bashar-ghosheh/WRO-Competition/ESP32-V3-pinout.webp

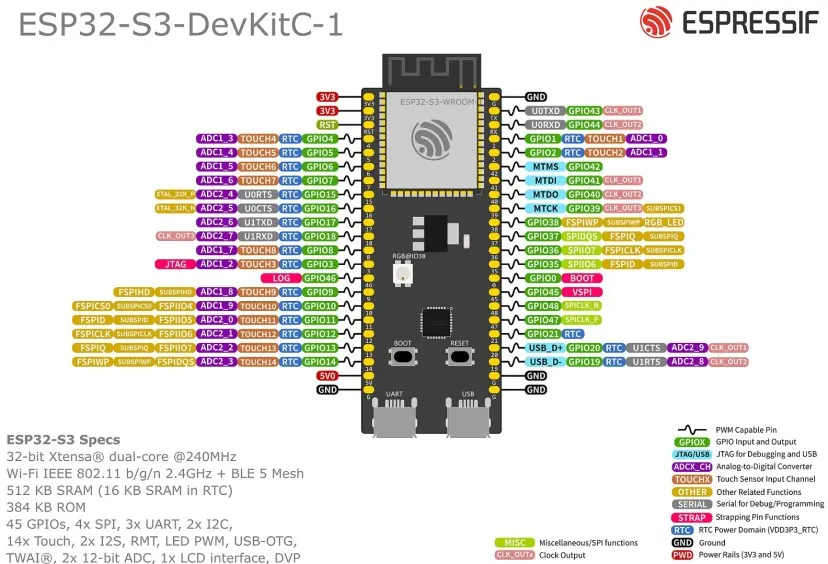
ESP32-V3-pinout.webp
