bashar-ghosheh/WRO-Competition/media/robot-photos/drivetrain_physical.jpeg

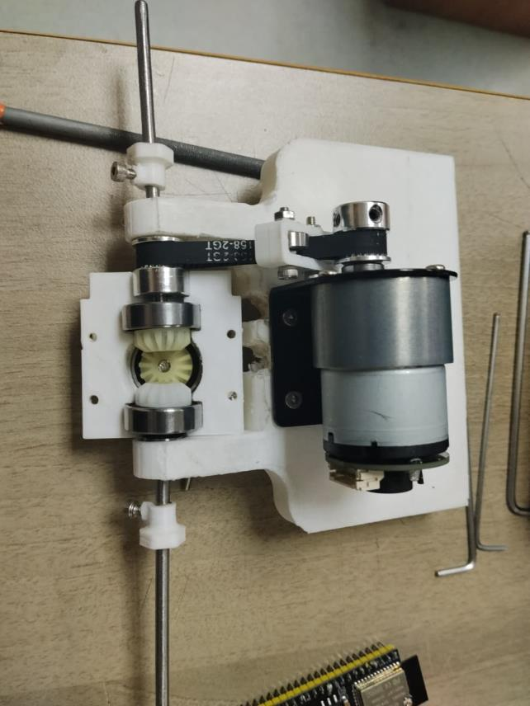
media/robot-photos/drivetrain_physical.jpeg
