bashar-ghosheh/WRO-Competition/cad/renders/differential_cad.jpeg

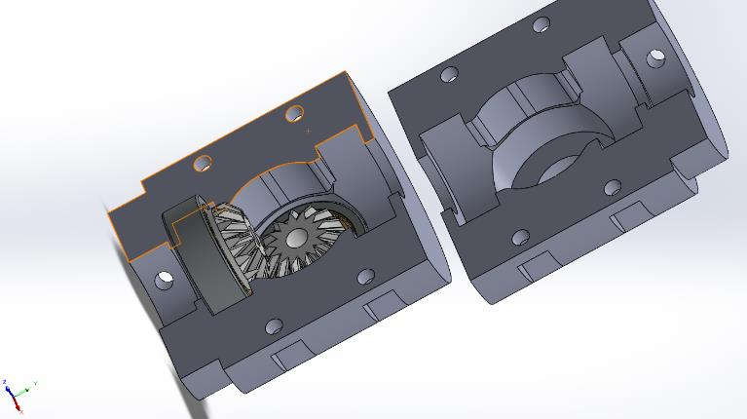
cad/renders/differential_cad.jpeg
