bashar-ghosheh/WRO-Competition/media/diagrams/control_flow.png

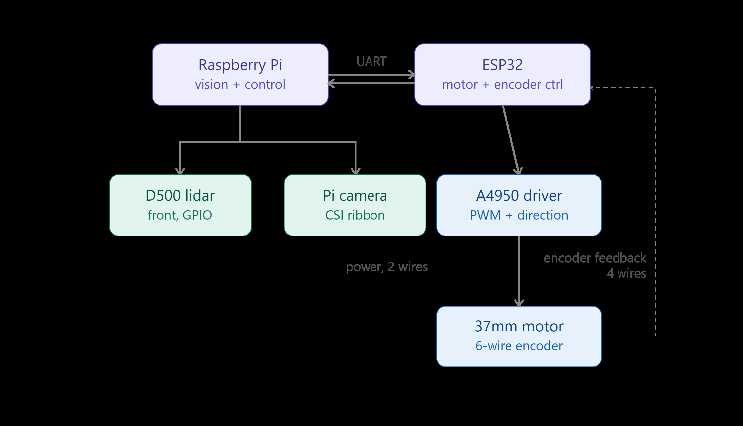
media/diagrams/control_flow.png
