bashar-ghosheh/WRO-Competition/media/diagrams/power_distribution.png

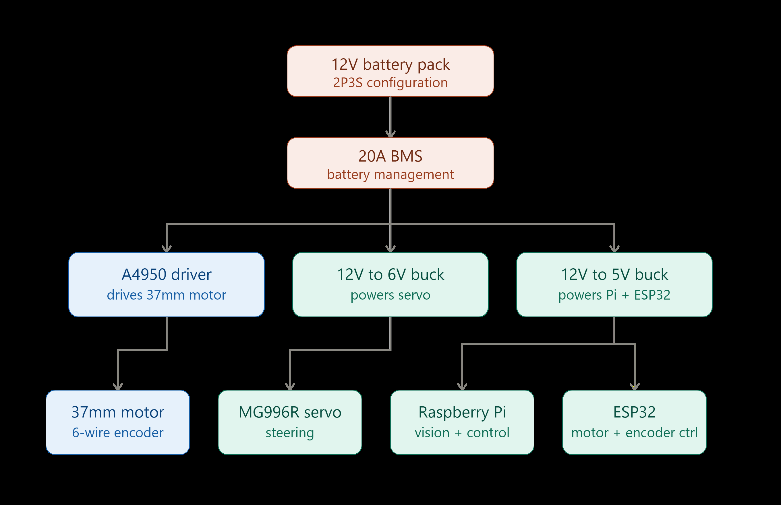
media/diagrams/power_distribution.png
