bashar-ghosheh/WRO-Competition/media/robot-photos/kodama_trinus.jpeg

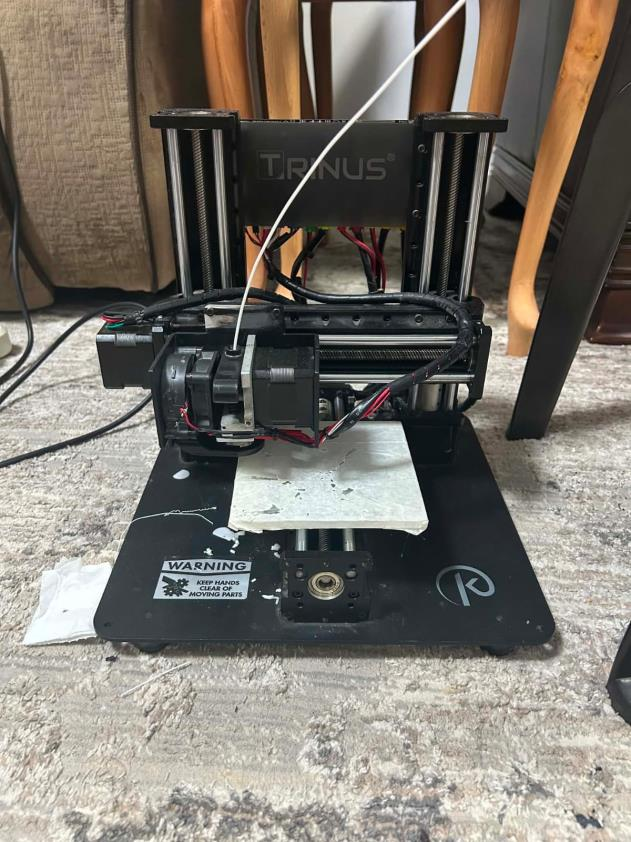
media/robot-photos/kodama_trinus.jpeg
