bashar-ghosheh/WRO-Competition/rpi4b-gpio.webp

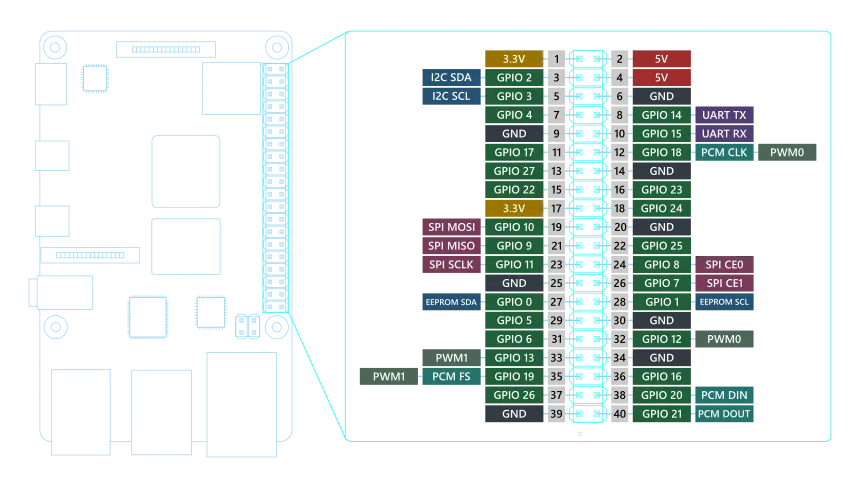
rpi4b-gpio.webp
