bashar-ghosheh/WRO-Competition/(commit log)

2026-07-21 Update steering limits to 90/60/120 to protect Ackerman servo linkage
2026-07-22 Add calibration/web_tuner.py for live ROI streaming over Wi-Fi
2026-07-22 Update vision crop height to 30px, lower contour area threshold to 50, and implement camera flip modes
    [camera_vision.py, hsv_tune.py, web_tuner.py]
2026-07-22 Update camera slice ROI bounds to y = 400 to 430 across all files
2026-07-22 Update camera slice ROI bounds to y = 300 to 400 across all files
2026-07-22 Update camera slice ROI bounds to y = 190 to 250 across all files
2026-07-22 Add calibration/lidar_plot.py for live 2D radar plotting of Lidar data
2026-07-22 Fix import paths in lidar_plot.py so it can be run directly
    [lidar_plot.py]
2026-07-22 Convert lidar_plot.py to a web server running on port 8001 for headless Raspberry Pi setups
2026-07-22 Update Lidar web plotter range to 1 meter and update grid markers
2026-07-22 Add firmware/servo_calibration/servo_calibration.ino C++ Arduino calibration sketch
2026-07-22 Add firmware/servo_web_calibration/servo_web_calibration.ino C++ Web Server Calibrator
2026-07-22 Document mechanical Ackermann geometry and power regulation architecture
2026-07-22 Document software architecture thread-design and engineering decisions journal
2026-07-22 Update docs with specific details from the WRO report: Kodama Trinus, 37mm gearmotor, 2P3S Samsung battery, BMS cooling, and A4950 driver selections
2026-07-22 Extract figures from report.pdf and embed physical photos and CAD renders into documentation files
2026-07-22 Comprehensive update for WRO 2026 rubric max scoring: 8.7k char README, speed/torque formulas, power budget table, performance metrics, and risk mitigation matrix
2026-07-23 Support GPIO UART hardware serial communication on ESP32-S3 and Pi
2026-07-23 Upgrade wall-following logic to Sector Minimum Projection algorithm (tilt and yaw immune)
2026-07-23 Update pin mappings: Motor Driver AIN1=16 AIN2=17, Encoders C1=32 C2=33, Lidar PWM=GPIO 12, and ESP32 UART RX=4 TX=5
2026-07-23 Configure SerialLink to use UART4 on /dev/ttyAMA1 (Physical Pins 21 & 24) for ESP32 link
2026-07-24 Update ESP32 serial link port to /dev/ttyAMA4 for Pi 4B UART4
2026-07-24 Fix RPi.GPIO mode allocation warning in LidarReader
    [lidar_reader.py]
